antonioMazzaccaro/smartCopertura_sisemb/src/prog/prog.ino

/*
    Copyright (C) 2024  Antonio Mazzaccaro

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
    You should have received a copy of the GNU General Public License
    along with this program.  If not, see <https://www.gnu.org/licenses/>.
*/

#include "lib.h"

//Tasks
Task audioTask(10, TASK_FOREVER, &campionaAudio);
Task chiediMeteoTask(120000, TASK_FOREVER, &chiediMeteoCallback);
Task leggiRispMeteoTask(5000, TASK_FOREVER, &leggiRispMeteo);
Task checkTask(500, TASK_FOREVER, &check);

Scheduler runner;

void setupScheduler() {
  runner.init();

  runner.addTask(audioTask);
  runner.addTask(chiediMeteoTask);
  runner.addTask(leggiRispMeteoTask);
  runner.addTask(checkTask);

  audioTask.enable();
  chiediMeteoTask.enable();
  leggiRispMeteoTask.enable();
  checkTask.enable();
}

void setup() {
  Serial.begin(115200);

  connectToWifi();

  setupAudio();
  Serial.println("audio OK");
  setupMotor();
  Serial.println("motore OK");
  setupContenitore();
  Serial.println("sensori/attuatori contenitore OK");
  setupScheduler();
  Serial.println("scheduler OK");
}

void loop() {
  runner.execute();
}
