antonioMazzaccaro/smartCopertura_sisemb/(commit log)

2024-04-09 sketch audio, motori, cliwnt wifi, client meteo
2024-04-10 PID resistenza contenitore
2024-04-13 step motor driver
2024-04-22 foto motore
2024-04-22 piedinatura esp32
